ATrappmann/PVMonitor/Trucki.h

// NAME: Trucki.h
//
#ifndef TRUCKI_H
#define TRUCKI_H

int  getTruckiMaxPower(String ip);
bool setTruckiMaxPower(String ip, uint16_t maxPower); 

//float getTruckiMeter(String ip);

#endif /* TRUCKI_H */
